morgensternR/cryocubed-circuits/circuit-code/swarm/Lockin/Lockin/README.md

# lockin_v7_chasedr_upython
Micropython code for the lockin_v7 board.
Microcontroller requires to be flashed with firmware.uf2
The microcontroller on the board should be connected to another microcontroller and communicate over the UART.

## circuitpython folder has code for a circuitpython board that will multiplex between multiple lockin boards
