morgensternR/cryocubed-circuits/circuit-code/swarm/Warm Up Heater/current_output.png

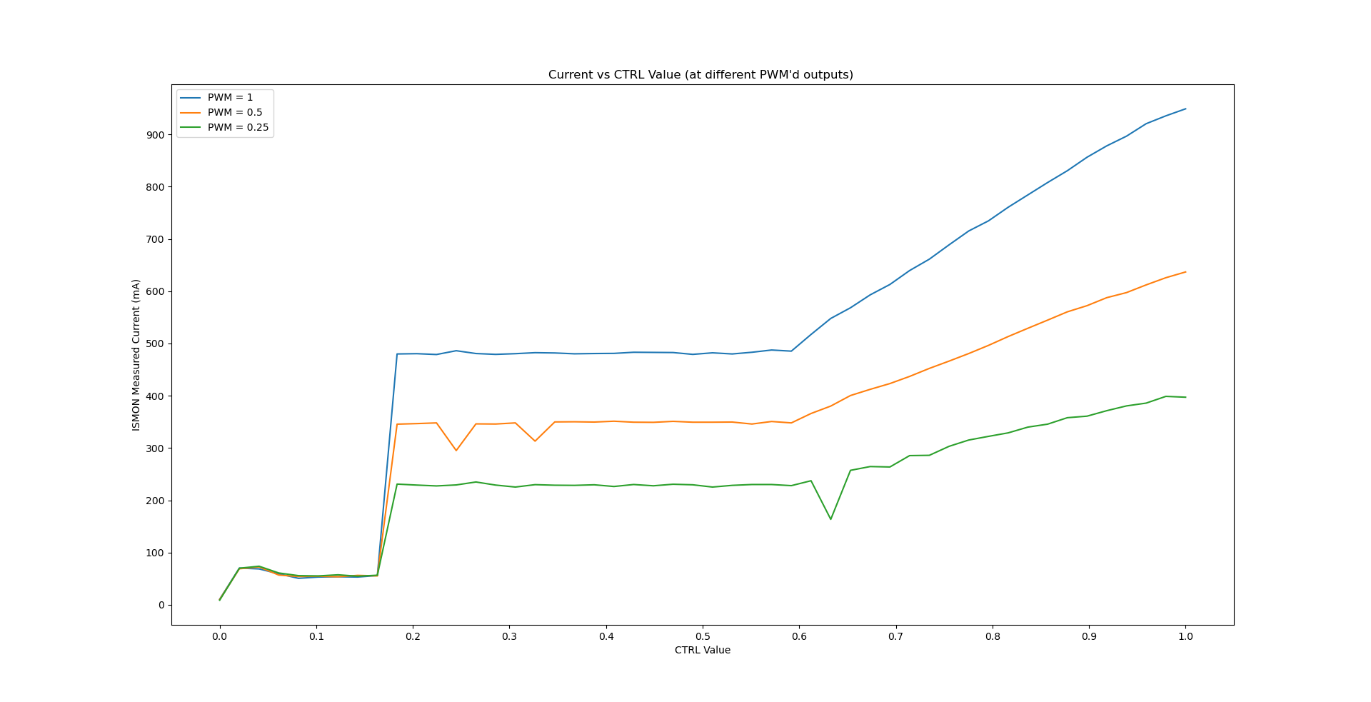
circuit-code/swarm/Warm Up Heater/current_output.png
