morgensternR/cryocubed-circuits/Diode Board/howland/G13792_BOM.xlsx

Ref | MPN | Qnty
C202, C201, C302, C301, C402, C401, C502, C501, | GRM31C5C1E104JA01L | 8
C203, C303, C403, C503, | CC0805KKX7R5BB105 | 4
C204, C304, C404, C504, | GRM31C5C1E104JA01L | 4
C205, C305, C405, C505, | F930J106KAA | 4
D201, D301, D401, D501, | 1N457ATR | 4
IC201, IC301, IC401, IC501, | LM334Z/LFT1 | 4
IC202, IC302, IC402, IC502, | AD8237ARMZ-R7 | 4
J101, J102, | A-DF 09 A/KG-T2S | 2
J104, J105, J103, J106, | 734130050 | 4
J107, J108, | B2B-PH-K-S(LF)(SN) | 2
L201, L301, L401, L501, | MMZ2012Y152BTD25 | 4
R201, R202, R301, R302, R401, R402, R501, R502, | RT0805DRE0710KL | 8
R203, R303, R403, R503, | RC0805FR-07133KL | 4
R204, R205, R304, R305, R404, R405, R504, R505, | RT0805DRE07100KL | 8
R206, R306, R406, R506, | RR1220P-1332-D-M | 4
