morgensternR/cryocubed-circuits/Diode Board/howland/howland.step

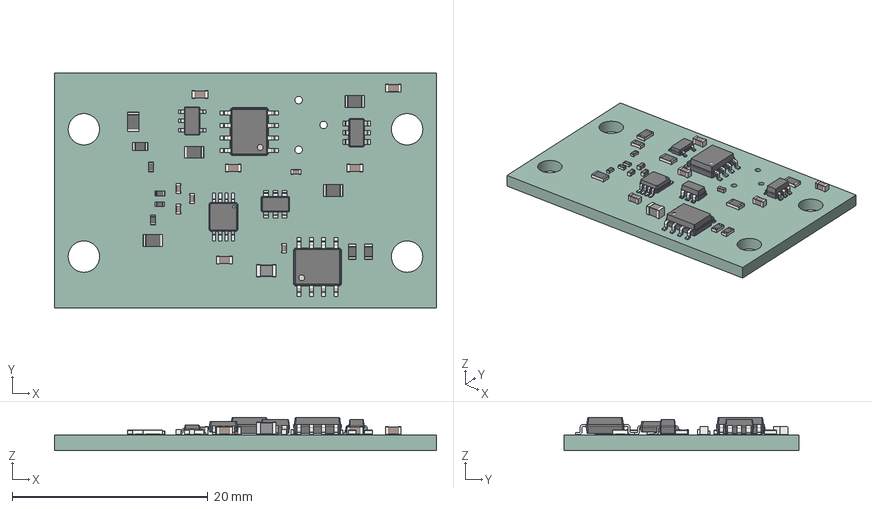
[picture p2: CAD file, 2024-10-29]
Diode Board/howland/howland.step
39.0 x 24.0 x 3.40 mm
howland PCB
