morgensternR/cryocubed-circuits/High Power Heater/TPS61165-heater-v8/TPS61165-heater-v8.step

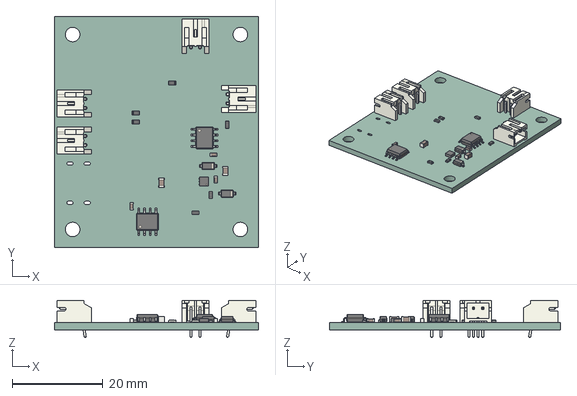
[picture p3: CAD file, 2024-10-29]
High Power Heater/TPS61165-heater-v8/TPS61165-heater-v8.step
45.0 x 51.0 x 8.25 mm
TPS61165-heater-v8 PCB
