morgensternR/cryocubed-circuits/(list of files, drawings)

Other design files:
sq_lockin_v9/freerouting.dsn
